AveryLion03/HearingAid/KiCad/HearingAid_ESPV3/HearingAid_ESP/HearingAid_Left/HearingAid_ESP.kicad_pcb

## KiCad design KiCad/HearingAid_ESPV3/HearingAid_ESP/HearingAid_Left/HearingAid_ESP.kicad_pcb (2025-03-31)

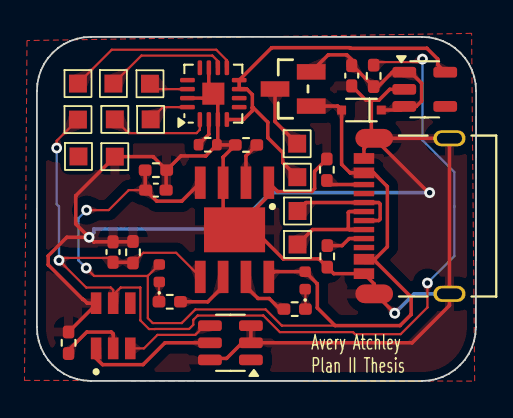
[picture p1: board HearingAid_ESP.kicad_pcb from above]

Board: 2 copper layers, 24.4 x 19.1 mm, 36 parts (1 on the bottom side), 24 nets.

Parts:
BT2: Battery_Cell; BatteryHolder_Keystone_3034_1x20mm_CustomCourtyard
C1: 4.7uF; C_0402_1005Metric_Pad0.74x0.62mm_HandSolder
C2: 10uF; C_0402_1005Metric_Pad0.74x0.62mm_HandSolder
C9: 100nF; C_0402_1005Metric_Pad0.74x0.62mm_HandSolder
D1: GREEN_LED; LED_0402_1005Metric
D2: RED_LED; LED_0402_1005Metric
D5: D_Schottky_Small_Filled; SOD323_F_
J1: 12402012E212A; AMPHENOL_12402012E212A
Q1: PMOS; DMP3099L-7_Correct
Q2: FS8205A; SOT-23-6
R1, R8: 100k; R_0402_1005Metric_Pad0.72x0.64mm_HandSolder
R2, R3: 5.1k; R_0402_1005Metric_Pad0.72x0.64mm_HandSolder
R4, R5, R7: 1k; R_0402_1005Metric_Pad0.72x0.64mm_HandSolder
R6: 2k; R_0402_1005Metric_Pad0.72x0.64mm_HandSolder
R9: 100; R_0402_1005Metric_Pad0.72x0.64mm_HandSolder
R10: 100k; R_0402_1005Metric
TP1, TP2, TP10, TP11, TP12, TP14, TP25, TP27, TP28, TP29, TP30, TP31: TestPoint; Mounting_Pad_Square
U1: AP2112K-3.3; SOT-23-5
U2: MAX98357A; TQFN-16-1EP_3x3mm_P0.5mm_EP1.23x1.23mm
U3: TP4056; SO08-PAD-300
U4: DW01A; SOT95P280X145-6N

Connections:
/G1: Q2.5, U4.1 (OD)
/G2: Q2.4, U4.3 (OC)
B+: BT2.1 (+), C9.1, R8.2, R9.1, TP27.1, U3.5 (BAT), U4.5 (VCC)
B-: BT2.2 (-), C1.2, C2.2, C9.2, J1.A1_B12 (GND), J1.B1_A12 (GND__1), J1.SH1 (SHIELD), J1.SH2 (SHIELD__1), J1.SH3 (SHIELD__2), J1.SH4 (SHIELD__3), Q2.2, Q2.3, Q2.6, R1.2, R2.1, R3.2, R6.1, R7.2, R9.2, R10.2, TP25.1, U1.2 (GND), U2.3 (GND), U2.11 (GND), U2.15 (GND), U2.17 (PAD), U3.1 (TEMP), U3.3 (GND), U3.PAD (GND), U4.6 (GND)
CLK1: TP11.1, U2.16 (BCLK)
D+: J1.A6 (D+_A), J1.B6 (D+_B), TP29.1
D-: J1.A7 (D-_A), J1.B7 (D-_B), TP28.1
unnamed: D1.1 (K), R5.1
unnamed: D2.1 (K), R4.1
unnamed: C1.1, D5.1 (K), Q1.3 (S), R8.1, U1.1 (VIN), U1.3 (EN)
unnamed: J1.A5 (CC1_A), R2.2
unnamed: J1.B5 (CC1_B), R3.1
unnamed: Q1.1 (D), TP31.1
unnamed: R10.1, U2.2 (GAIN_SLOT)
unnamed: R6.2, U3.2 (PROG)
unnamed: R4.2, U3.7 (~CHRG)
unnamed: R5.2, U3.6 (~STDBY)
unnamed: R7.1, U4.2 (CS)
SEL1: TP10.1, U2.14 (LRCLK)
SPK_DATA1: TP12.1, U2.1 (DIN)
SPK_N1: TP2.1, U2.10 (OUTN)
SPK_P1: TP1.1, U2.9 (OUTP)
VBUS: C2.1, D1.2 (A), D2.2 (A), D5.2 (A), J1.A4_B9 (VBUS), J1.B4_A9 (VBUS__1), Q1.2 (G), R1.1, U3.4 (VCC), U3.8 (CE)
VDD_ESP: TP30.1, U1.5 (VOUT), U2.4 (~SD_MODE), U2.7 (VDD), U2.8 (VDD)
