AveryLion03/HearingAid/KiCad/HearingAid_ESPV3/HearingAid_ESP/HearingAid_Right V3/HearingAid_RightV3.kicad_pcb

## KiCad design KiCad/HearingAid_ESPV3/HearingAid_ESP/HearingAid_Right V3/HearingAid_RightV3.kicad_pcb (2025-03-31)

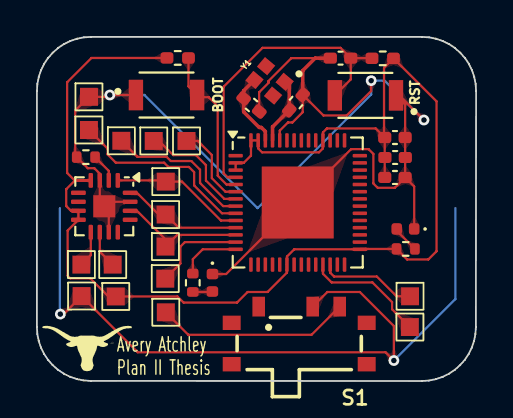
[picture p2: board HearingAid_RightV3.kicad_pcb from above]

Board: 2 copper layers, 24.4 x 19.1 mm, 36 parts (1 on the bottom side), 24 nets.

Parts:
BT1: Battery_Cell; BatteryHolder_Keystone_3034_1x20mm_CustomCourtyard
C3: 4.7uF; C_0402_1005Metric_Pad0.74x0.62mm_HandSolder
C4: 100nF; C_0402_1005Metric_Pad0.74x0.62mm_HandSolder
C5, C8: 1uF; C_0402_1005Metric_Pad0.74x0.62mm_HandSolder
C6, C7: 10pF; C_0402_1005Metric_Pad0.74x0.62mm_HandSolder
D3: RED_LED; LED_0402_1005Metric
D4: GREEN_LED; LED_0402_1005Metric
R11, R12: 470; R_0402_1005Metric
R13: 100k; R_0402_1005Metric
R14, R15: 10k; R_0402_1005Metric_Pad0.72x0.64mm_HandSolder
RST: SW_Push; SW_B3U-1000P
S1: 450404015514
SW2: BOOT; SW_B3U-1000P
TP3, TP4, TP6, TP7, TP8, TP9, TP13, TP15, TP16, TP17, TP18, TP20, TP21, TP22, TP23, TP24: TestPoint; Mounting_Pad_Square
U5: MAX98357A; TQFN-16-1EP_3x3mm_P0.5mm_EP1.23x1.23mm
U8: ESP32-S3; QFN-56-1EP_7x7mm_P0.4mm_EP4x4mm
Y1: XRCGB40M000F1S1BR0; OSC_XRCGB40M000F1S1BR0

Connections:
B+: BT1.1 (+), S1.2, TP24.1
B-: BT1.2 (-), C3.2, C4.2, C5.2, C6.2, C7.1, C8.2, D3.1 (K), D4.1 (K), R13.2, RST.1, SW2.1, TP6.1, U5.3 (GND), U5.11 (GND), U5.15 (GND), U5.17 (PAD), U8.52 (GPIO46), U8.57 (GND)
BOOT: R15.2, SW2.2, U8.5 (GPIO0)
CLK1: TP16.1, U8.7 (GPIO2)
CLK2: TP8.1, U5.16 (BCLK), U8.11 (GPIO6)
D+: TP23.1, U8.26 (GPIO20/USB_D+)
D-: TP22.1, U8.25 (GPIO19/USB_D-)
MIC_DATA1: TP18.1, U8.9 (GPIO4)
MIC_DATA2: TP13.1, U8.13 (GPIO8)
unnamed: D3.2 (A), R11.2
unnamed: D4.2 (A), R12.1
unnamed: S1.3, TP21.1
unnamed: R13.1, U5.2 (GAIN_SLOT)
unnamed: R12.2, U8.14 (GPIO9)
unnamed: C7.2, U8.53 (XTAL_N), Y1.1
unnamed: C6.1, U8.54 (XTAL_P), Y1.3
RESET: C5.1, R14.2, RST.2, U8.4 (CHIP_PU)
SEL1: TP15.1, U8.8 (GPIO3)
SEL2: TP7.1, U5.14 (LRCLK), U8.12 (GPIO7)
SPK2_DATA: TP9.1, U5.1 (DIN), U8.10 (GPIO5)
SPK2_N: TP4.1, U5.10 (OUTN)
SPK2_P: TP3.1, U5.9 (OUTP)
SPK_DATA1: TP17.1, U8.6 (GPIO1)
VDD_ESP: C3.1, C4.1, C8.1, R11.1, R14.1, R15.1, TP20.1, U5.4 (~SD_MODE), U5.7 (VDD), U5.8 (VDD), U8.2 (VDD3P3), U8.3 (VDD3P3), U8.20 (VDD3P3_RTC), U8.29 (VDD_SPI), U8.46 (VDD3P3_CPU), U8.55 (VDDA), U8.56 (VDDA)
