AveryLion03/HearingAid/(commit log)

2025-01-22 Create hearingaid_testy.ino
    Test code for nRF52840 for a hearing aid design. Using I2S for input (microphone) and output (speaker). Debugging using blinking LED.
2025-02-08 pwm/timer support
2025-02-19 Updated Hearing Aid
    [HearingAid_ESP.kicad_pcb, HearingAid_ESP.kicad_sch]
2025-02-19 Updating files
    [HearingAid_ESP.kicad_pcb]
2025-02-19 Removed microphone footprint
    [HearingAid_ESP.kicad_pcb]
2025-03-07 Updated hearing aid files
    [HearingAid_ESP.csv, HearingAid_ESP.kicad_pcb, HearingAid_ESP.kicad_sch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]
